pondahai/SDR/README.md

# SDR
my sdr

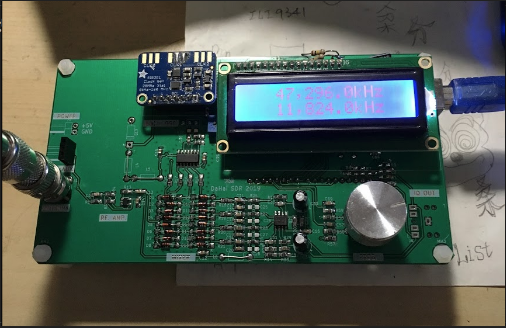
[picture p1: sdr-hardware.png]

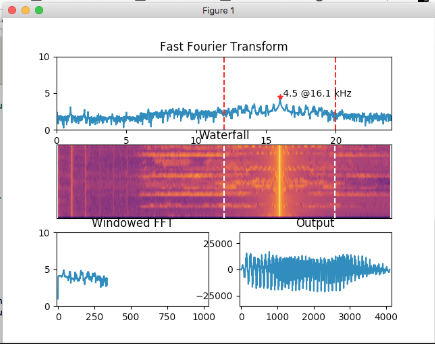
[picture p2: sdr-software.png]
