pondahai/SDR/hardware/kicad/SDR_RECEIVER/SDR_RECEIVER.kicad_pcb

## KiCad design hardware/kicad/SDR_RECEIVER/SDR_RECEIVER.kicad_pcb (2019-08-18)

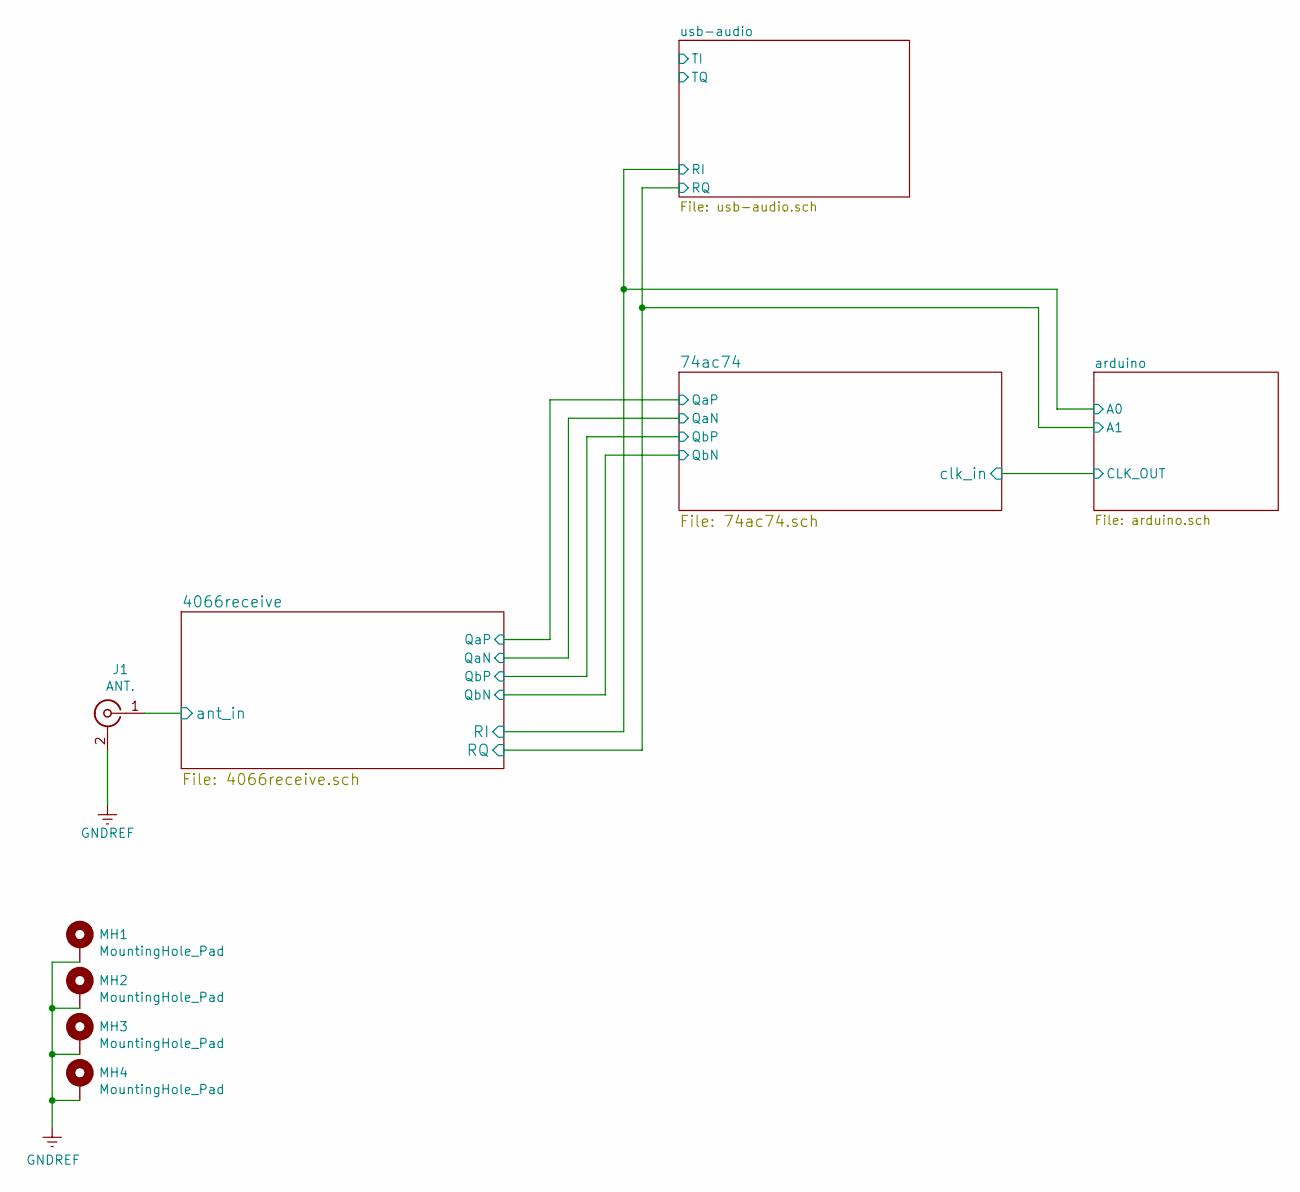
[picture p3: schematic SDR_RECEIVER.sch]

Parts:
J1: ANT.; BNC_TEConnectivity_1478204_Vertical
MH1, MH2, MH3, MH4: MountingHole_Pad; MountingHole_3.2mm_M3_Pad

Connections:
/4066receive/ant_in: J1.1 (In); also elsewhere on the board
GND: J1.2 (Ext), MH1.1, MH2.1, MH3.1, MH4.1; also elsewhere on the board

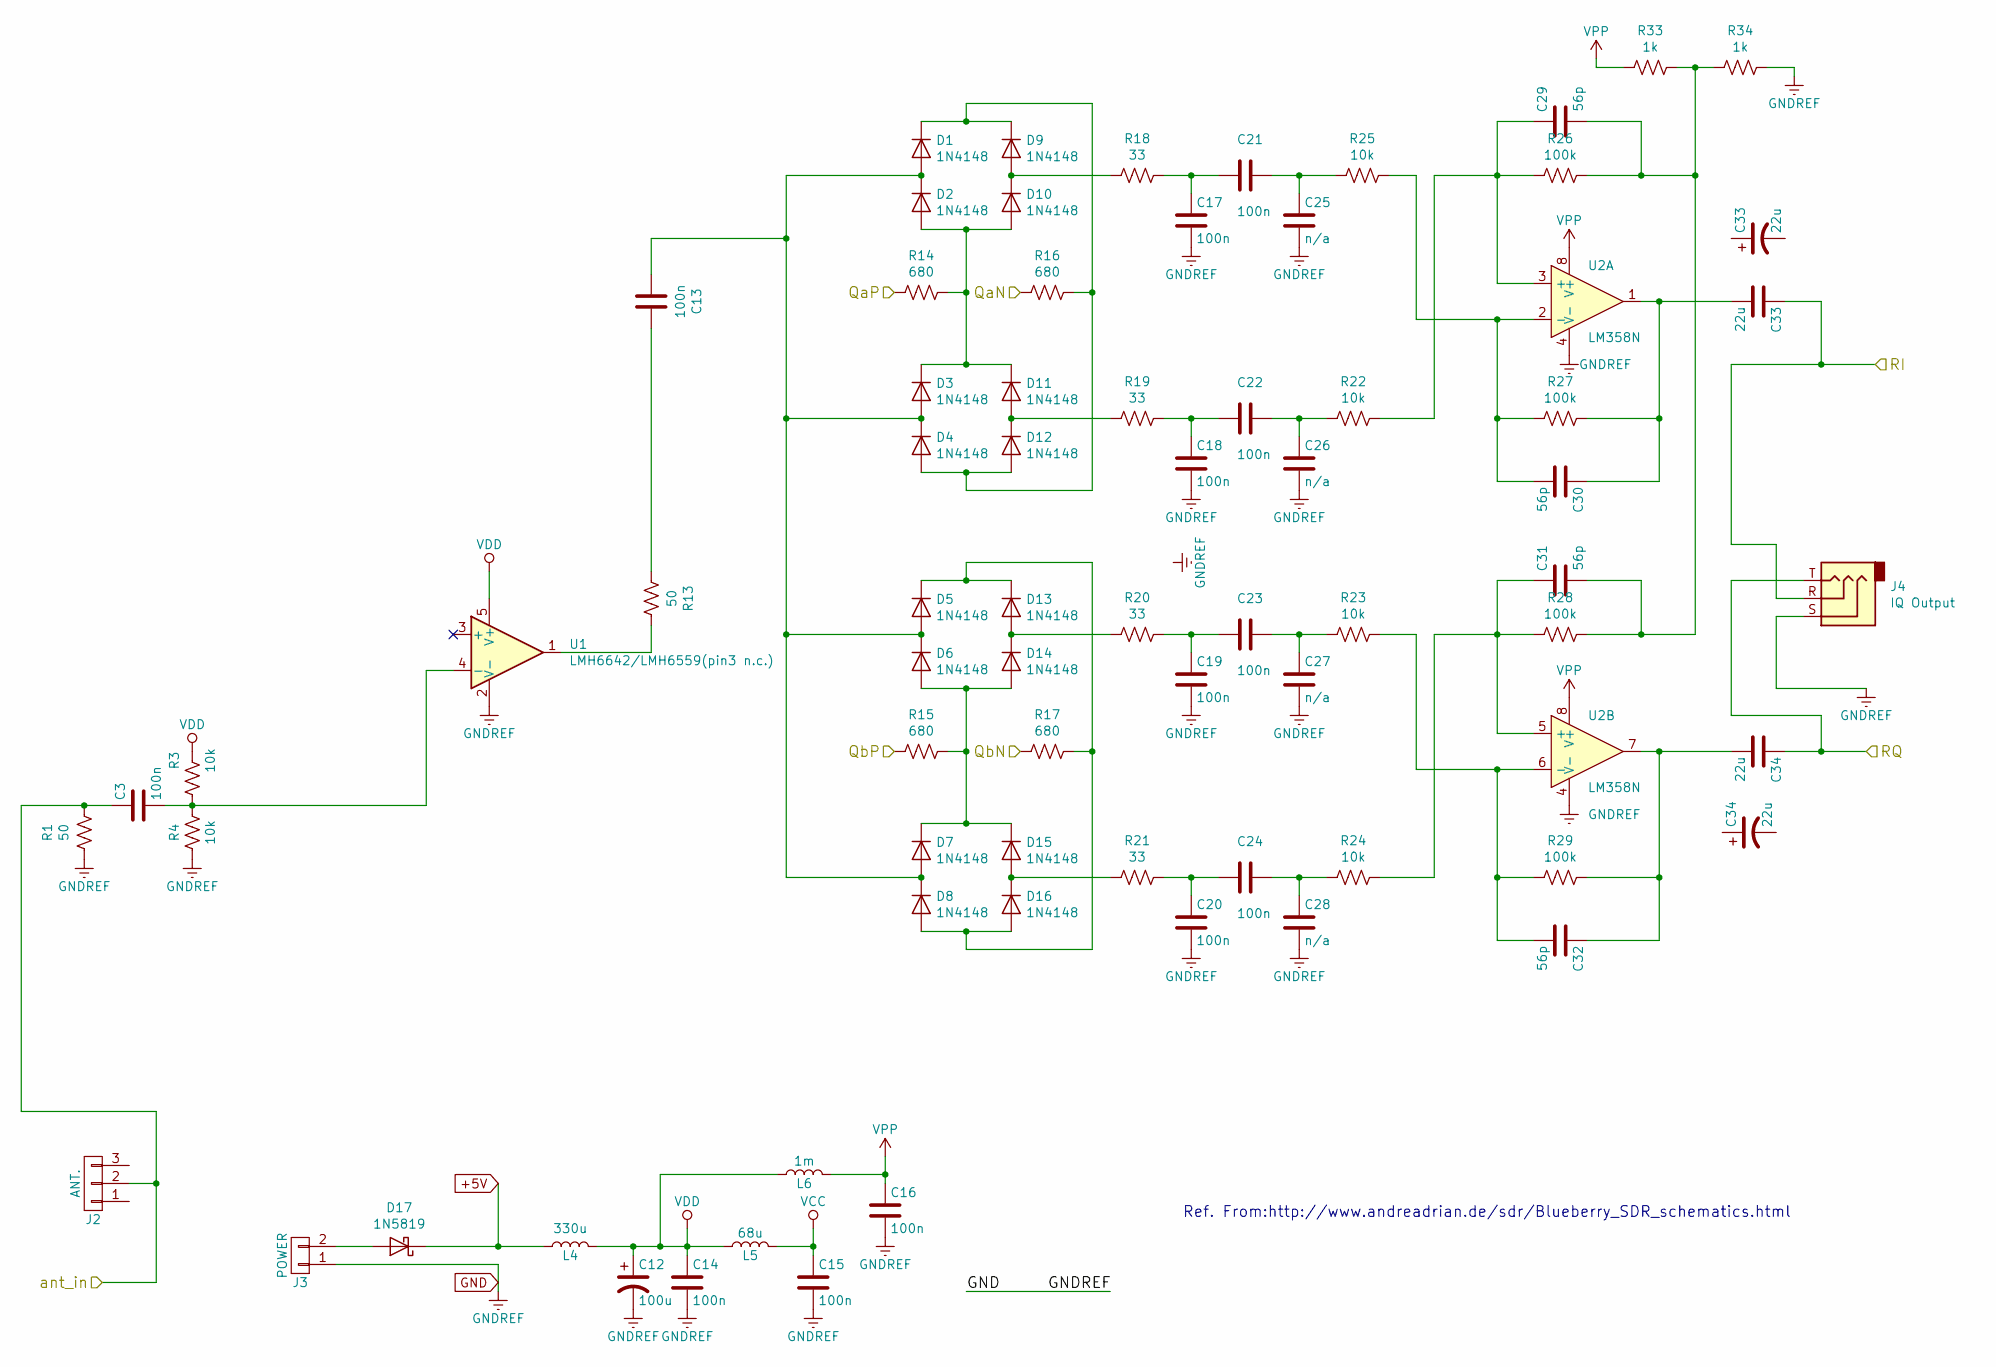
[picture p4: schematic 4066receive.sch]

Parts:
C3, C13, C14, C15, C16, C17, C18, C19, C20: 100n; C_0805_HandSoldering
C12: 100u; C_0805_HandSoldering
C21, C22, C23, C24: 100n; C_1206_3216Metric
C25, C26, C27, C28: n/a; C_0805_HandSoldering
C29, C30, C31, C32: 56p; C_0805_HandSoldering
C33, C34: 22u; CP_Radial_D6.3mm_P2.50mm
D1, D2, D3, D4, D5, D6, D7, D8, D9, D10, D11, D12, D13, D14, D15, D16: 1N4148; D_DO-35_SOD27_P7.62mm_Horizontal
D17: 1N5819; D_DO-41_SOD81_P10.16mm_Horizontal
J2: ANT.; Pin_Header_Angled_1x03_Pitch2.54mm
J3: POWER; Pin_Header_Angled_1x02_Pitch2.54mm
J4: IQ Output; audiojack-3.5mm-5p
L4: 330u; Choke_Horizontal_RM10mm
L5: 68u; Choke_Horizontal_RM10mm
L6: 1m; Choke_Horizontal_RM10mm
R1, R13: 50; R_0805_HandSoldering
R3, R4, R22, R23, R24, R25: 10k; R_0805_HandSoldering
R14, R15, R16, R17: 680; R_0805_HandSoldering
R18, R19, R20, R21: 33; R_0805_HandSoldering
R26, R27, R28, R29: 100k; R_0805_HandSoldering
R33, R34: 1k; R_0805_HandSoldering
U1: LMH6642/LMH6559(pin3 n.c.); TSOT-23-5
U2: LM358N; SOIC-8_3.9x4.9mm_P1.27mm

Connections:
+5V: D17.1 (K), L4.1; also elsewhere on the board
/4066receive/QaN: R16.2; also elsewhere on the board
/4066receive/QaP: R14.2; also elsewhere on the board
/4066receive/QbN: R17.2; also elsewhere on the board
/4066receive/QbP: R15.2; also elsewhere on the board
/4066receive/ant_in: C3.1, J2.2, R1.1; also elsewhere on the board
/arduino/A0: C33.1, J4.R; also elsewhere on the board
/arduino/A1: C34.1, J4.T; also elsewhere on the board
GND: C12.2, C14.2, C15.2, C16.2, C17.2, C18.2, C19.2, C20.2, C25.2, C26.2, C27.2, C28.2, J3.1, J4.S, R1.2, R4.2, R34.1, U1.2 (V-), U2.4 (V-); also elsewhere on the board
unnamed: C3.2, R3.2, R4.1, U1.4 (-)
unnamed: C13.1, R13.2
unnamed: C13.2, D1.2 (A), D2.1 (K), D3.2 (A), D4.1 (K), D5.2 (A), D6.1 (K), D7.2 (A), D8.1 (K)
unnamed: C17.1, C21.2, R18.1
unnamed: C18.1, C22.2, R19.1
unnamed: C19.1, C23.2, R20.1
unnamed: C20.1, C24.2, R21.1
unnamed: C21.1, C25.1, R25.2
unnamed: C22.1, C26.1, R22.2
unnamed: C23.1, C27.1, R23.2
unnamed: C24.1, C28.1, R24.2
unnamed: C29.1, C31.1, R26.1, R28.1, R33.1, R34.2
unnamed: C29.2, R22.1, R26.2, U2.3 (+)
unnamed: C30.1, C33.2, R27.1, U2.1
unnamed: C30.2, R25.1, R27.2, U2.2 (-)
unnamed: C31.2, R24.1, R28.2, U2.5 (+)
unnamed: C32.1, C34.2, R29.1, U2.7
unnamed: C32.2, R23.1, R29.2, U2.6 (-)
unnamed: D1.1 (K), D4.2 (A), D9.1 (K), D12.2 (A), R16.1
unnamed: D9.2 (A), D10.1 (K), R18.2
unnamed: D2.2 (A), D3.1 (K), D10.2 (A), D11.1 (K), R14.1
unnamed: D11.2 (A), D12.1 (K), R19.2
unnamed: D5.1 (K), D8.2 (A), D13.1 (K), D16.2 (A), R17.1
unnamed: D13.2 (A), D14.1 (K), R20.2
unnamed: D6.2 (A), D7.1 (K), D14.2 (A), D15.1 (K), R15.1
unnamed: D15.2 (A), D16.1 (K), R21.2
unnamed: D17.2 (A), J3.2
unnamed: R13.1, U1.1
VCC: C15.1, L5.2; also elsewhere on the board
VDD: C12.1, C14.1, L4.2, L5.1, L6.1, R3.1, U1.5 (V+)
VPP: C16.1, L6.2, R33.2, U2.8 (V+)

Notes on the sheet:
Ref. From:http://www.andreadrian.de/sdr/Blueberry_SDR_schematics.html

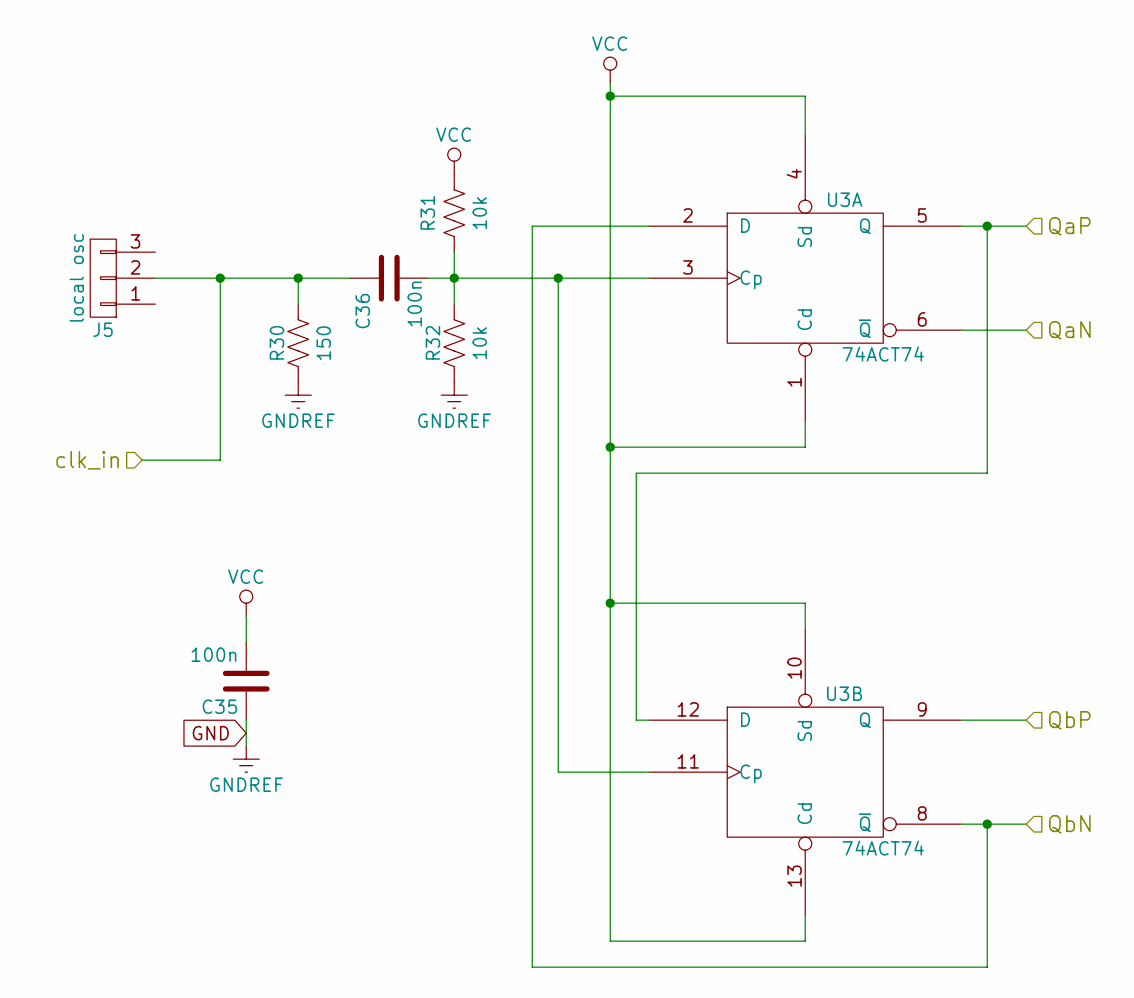
[picture p5: schematic 74ac74.sch]

Parts:
C35, C36: 100n; C_0805_HandSoldering
J5: local osc; PinHeader_1x03_P2.54mm_Vertical
R30: 150; R_0805_HandSoldering
R31, R32: 10k; R_0805_HandSoldering
U3: 74ACT74; SOIC-14_3.9x8.7mm_P1.27mm

Connections:
/4066receive/QaN: U3.6 (~Q); also elsewhere on the board
/4066receive/QaP: U3.5 (Q), U3.12 (D); also elsewhere on the board
/4066receive/QbN: U3.2 (D), U3.8 (~Q); also elsewhere on the board
/4066receive/QbP: U3.9 (Q); also elsewhere on the board
/arduino/CLK_OUT: C36.2, J5.2, R30.2; also elsewhere on the board
GND: C35.1, R30.1, R32.1, U3.7 (GND); also elsewhere on the board
unnamed: C36.1, R31.1, R32.2, U3.3 (Cp), U3.11 (Cp)
VCC: C35.2, R31.2, U3.1 (Cd), U3.4 (Sd), U3.10 (Sd), U3.13 (Cd), U3.14 (VCC); also elsewhere on the board

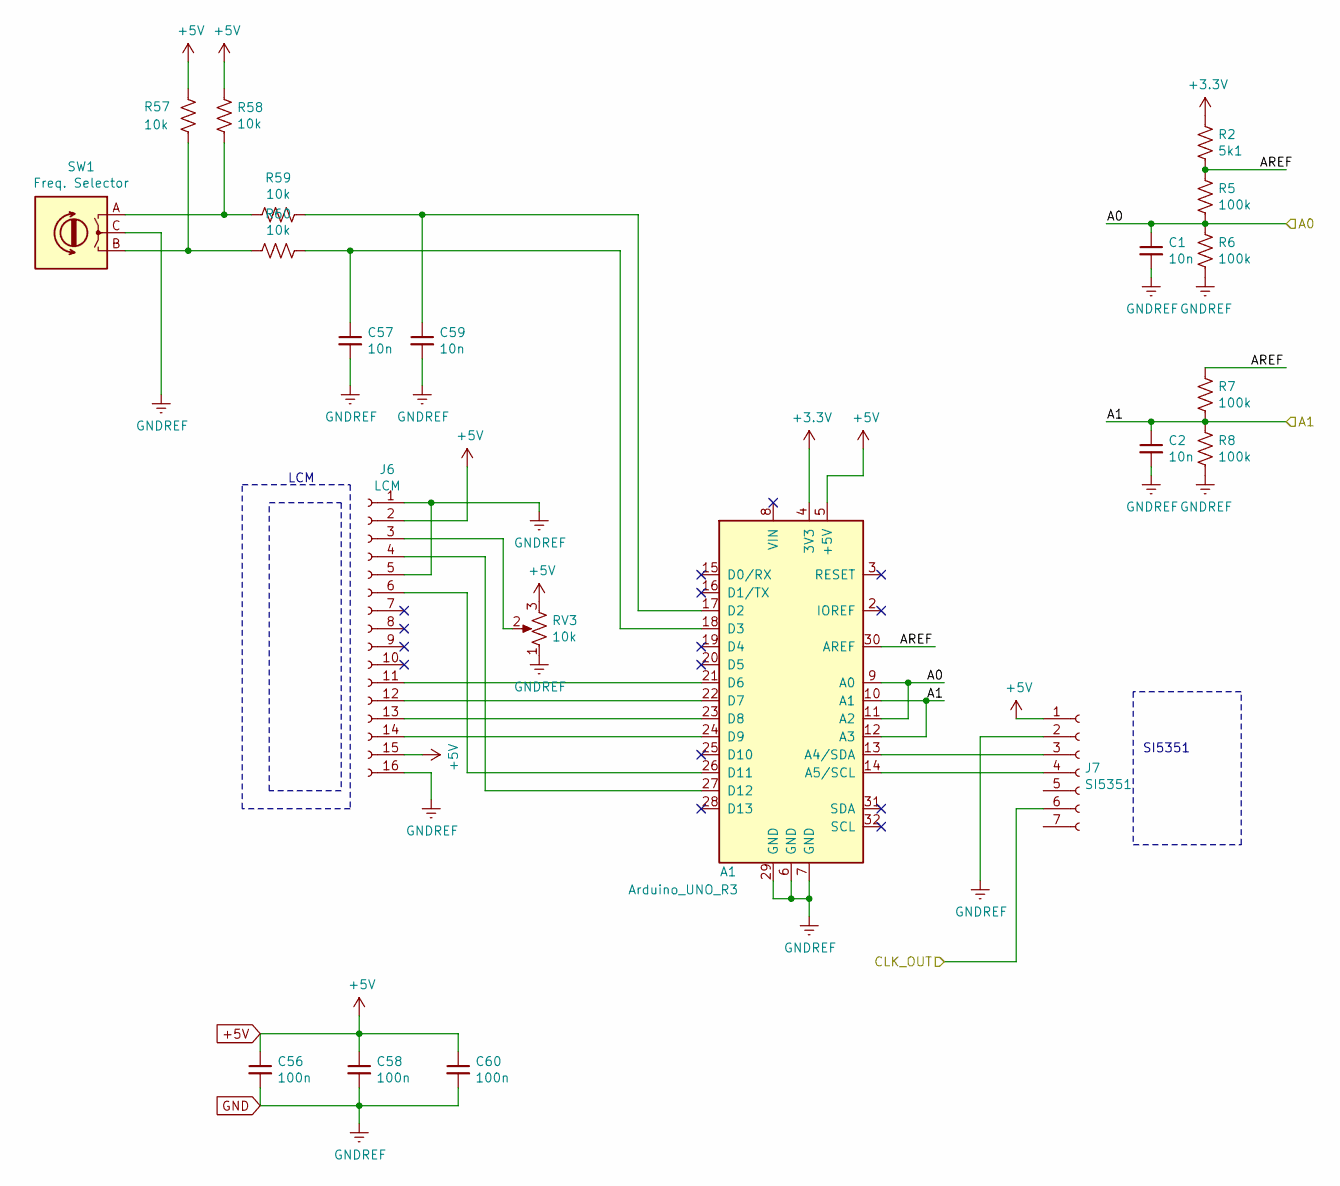
[picture p6: schematic arduino.sch]

Parts:
A1: Arduino_UNO_R3
C1, C2, C57, C59: 10n; C_0805_HandSoldering
C56, C58, C60: 100n; C_0805_HandSoldering
J6: LCM; PinSocket_1x16_P2.54mm_Vertical
J7: SI5351; PinSocket_1x07_P2.54mm_Vertical
R2: 5k1; R_0805_HandSoldering
R5, R6, R7, R8: 100k; R_0805_HandSoldering
R57, R58, R59, R60: 10k; R_0805_HandSoldering
RV3: 10k; Potentiometer_ACP_CA6-H2,5_Horizontal
SW1: Freq. Selector; RotaryEncoder_Alps_EC11E_Vertical_H20mm

Connections:
+3V3: A1.4 (3V3), R2.1
+5V: A1.5 (+5V), C56.1, C58.1, C60.1, J6.2, J6.15, J7.1, R57.1, R58.1, RV3.3; also elsewhere on the board
/arduino/A0: A1.9 (A0), A1.11 (A2), C1.1, R5.2, R6.1; also elsewhere on the board
/arduino/A1: A1.10 (A1), A1.12 (A3), C2.1, R7.2, R8.1; also elsewhere on the board
/arduino/AREF: A1.30 (AREF), R2.2, R5.1, R7.1
/arduino/CLK_OUT: J7.6; also elsewhere on the board
GND: A1.6 (GND), A1.7 (GND), A1.29 (GND), C1.2, C2.2, C56.2, C57.2, C58.2, C59.2, C60.2, J6.1, J6.5, J6.16, J7.2, R6.2, R8.2, RV3.1, SW1.C; also elsewhere on the board
unnamed: A1.13 (A4/SDA), J7.3
unnamed: A1.14 (A5/SCL), J7.4
unnamed: A1.17 (D2), C59.1, R59.2
unnamed: A1.18 (D3), C57.1, R60.2
unnamed: A1.21 (D6), J6.11
unnamed: A1.22 (D7), J6.12
unnamed: A1.23 (D8), J6.13
unnamed: A1.24 (D9), J6.14
unnamed: A1.26 (D11), J6.6
unnamed: A1.27 (D12), J6.4
unnamed: J6.3, RV3.2
unnamed: R57.2, R60.1, SW1.B
unnamed: R58.2, R59.1, SW1.A

Notes on the sheet:
SI5351
LCM

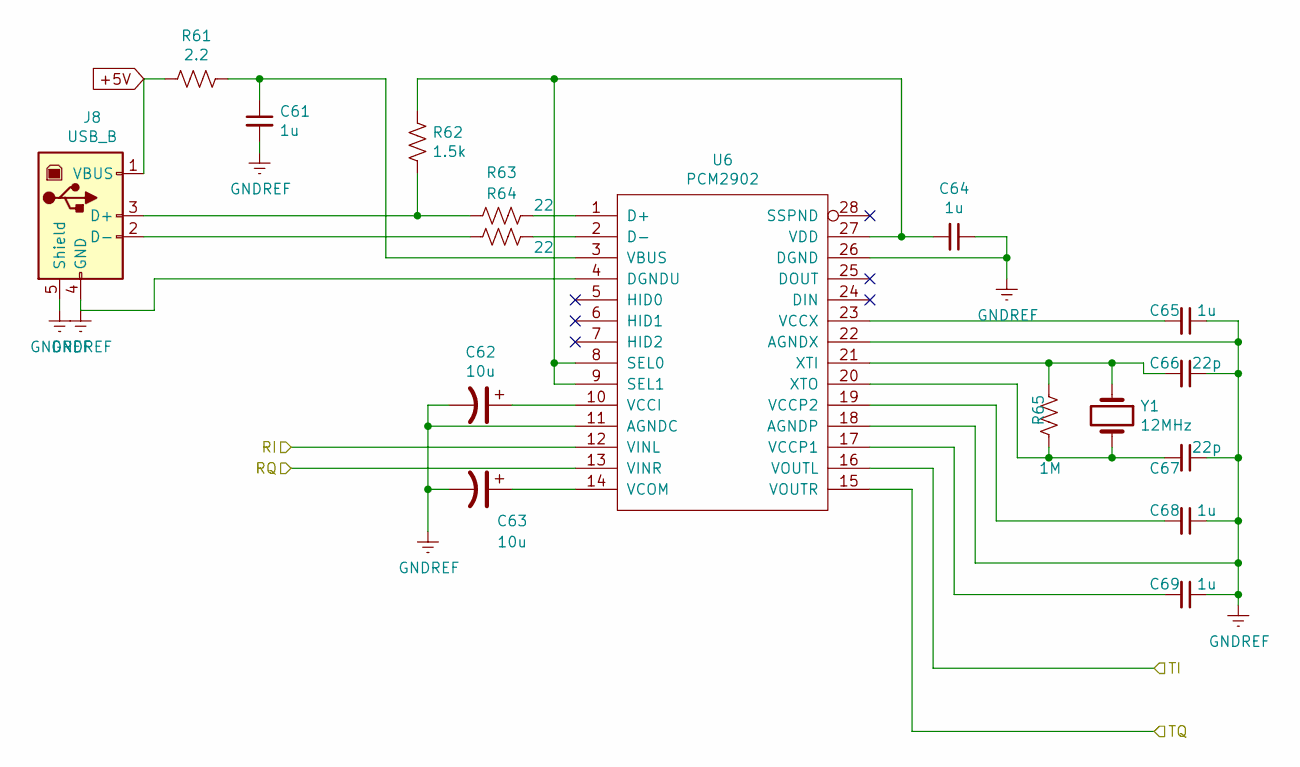
[picture p7: schematic usb-audio.sch]

Parts:
C61, C64, C65, C68, C69: 1u; C_0805_HandSoldering
C62, C63: 10u; CP_Elec_6.3x4.5
C66, C67: 22p; C_0805_HandSoldering
J8: USB_B
R61: 2.2; R_0805_HandSoldering
R62: 1.5k; R_0805_HandSoldering
R63, R64: 22; R_0805_HandSoldering
R65: 1M; R_0805_HandSoldering
U6: PCM2902; SSOP-28_5.3x10.2mm_P0.65mm
Y1: 12MHz; Crystal_HC18-U_Vertical

Connections:
+5V: J8.1 (VBUS), R61.2; also elsewhere on the board
/arduino/A0: U6.12 (VINL); also elsewhere on the board
/arduino/A1: U6.13 (VINR); also elsewhere on the board
GND: C61.2, C62.2, C63.2, C64.1, C65.1, C66.1, C67.1, C68.1, C69.1, J8.4 (GND), J8.5 (Shield), U6.4 (DGNDU), U6.11 (AGNDC), U6.18 (AGNDP), U6.22 (AGNDX), U6.26 (DGND); also elsewhere on the board
unnamed: C61.1, R61.1, U6.3 (VBUS)
unnamed: C62.1, U6.10 (VCCI)
unnamed: C63.1, U6.14 (VCOM)
unnamed: C64.2, R62.2, U6.8 (SEL0), U6.9 (SEL1), U6.27 (VDD)
unnamed: C65.2, U6.23 (VCCX)
unnamed: C66.2, R65.2, U6.21 (XTI), Y1.1
unnamed: C67.2, R65.1, U6.20 (XTO), Y1.2
unnamed: C68.2, U6.19 (VCCP2)
unnamed: C69.2, U6.17 (VCCP1)
unnamed: J8.2 (D-), R64.2
unnamed: J8.3 (D+), R62.1, R63.2
unnamed: R63.1, U6.1 (D+)
unnamed: R64.1, U6.2 (D-)

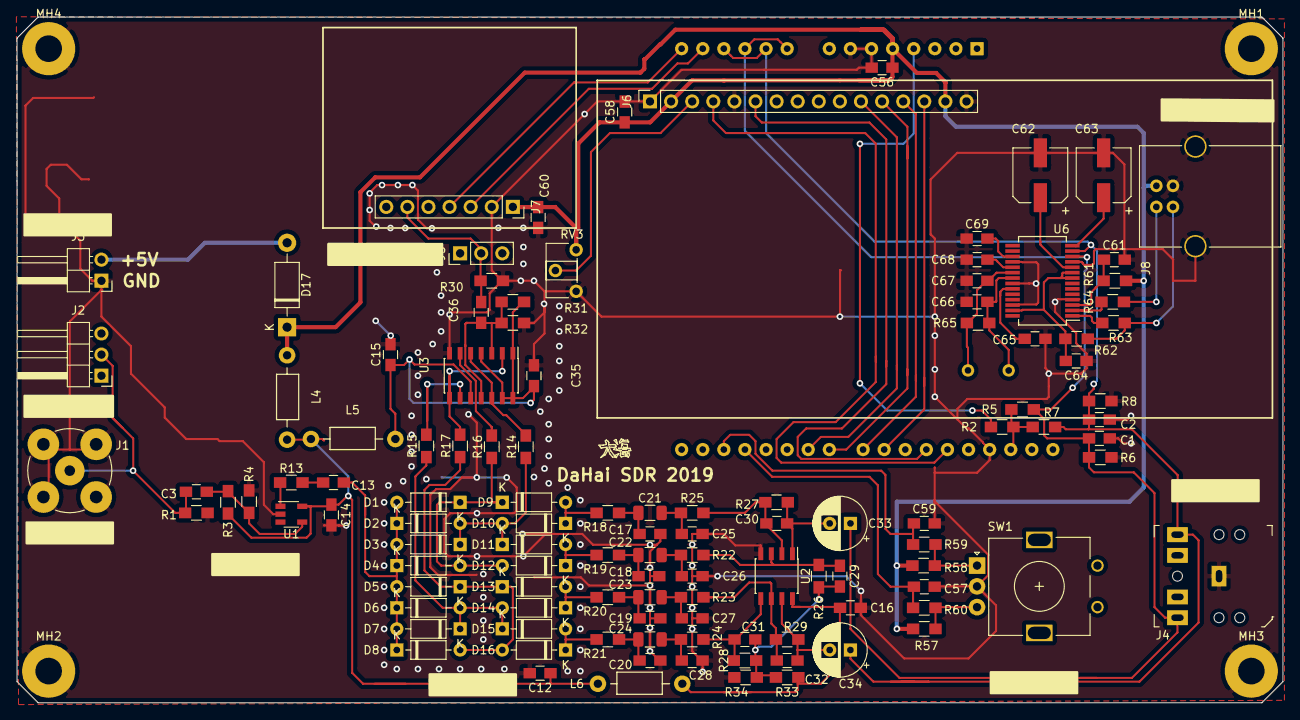
[picture p8: board SDR_RECEIVER.kicad_pcb from above]

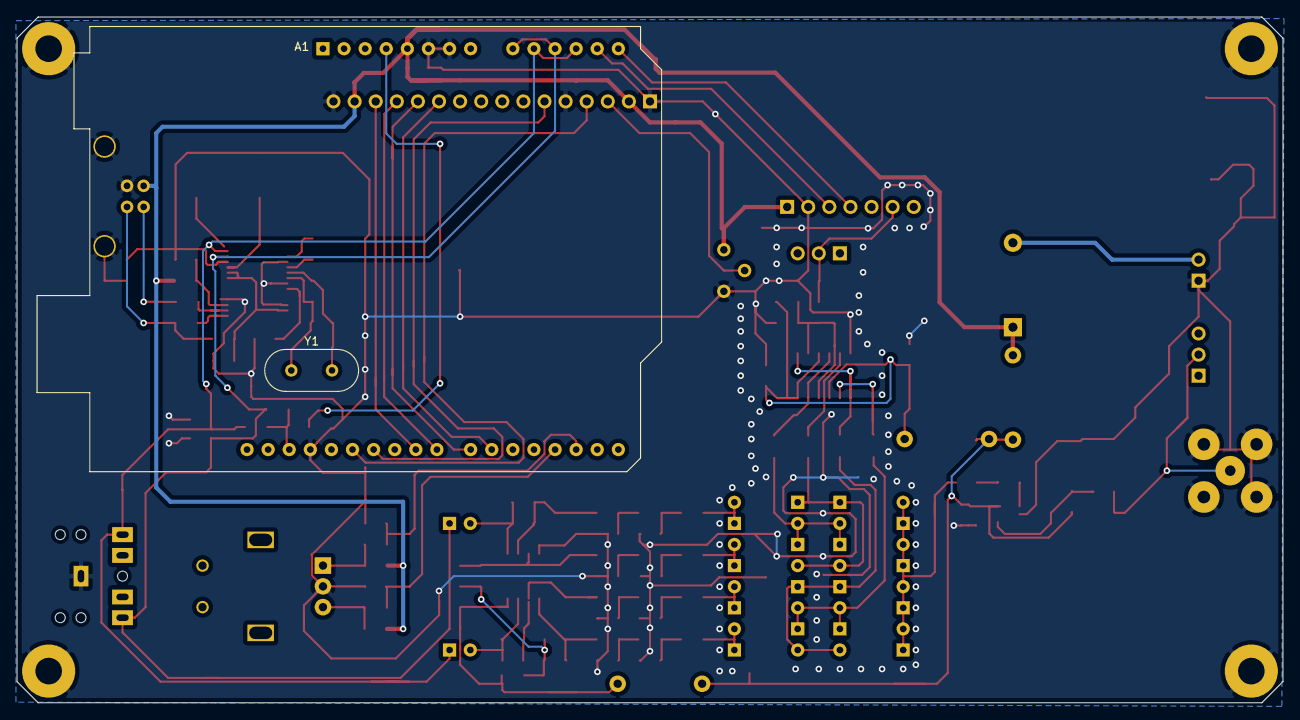
[picture p9: board SDR_RECEIVER.kicad_pcb from below]

Board: 2 copper layers, 152.4 x 82.6 mm, 121 parts (2 on the bottom side), 70 nets.
